yohandev/6115-final-project/proposal/images/hardware_overview.png

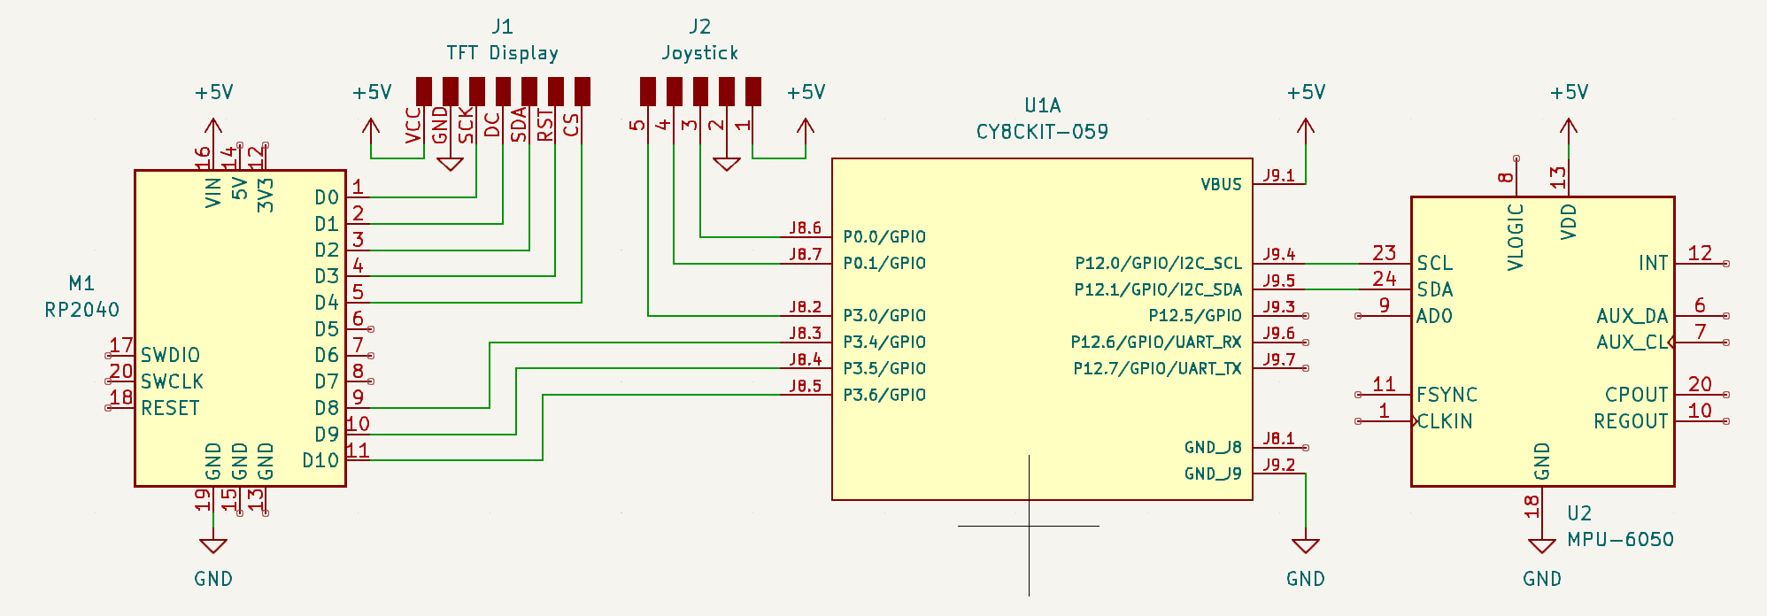
proposal/images/hardware_overview.png
