yohandev/6115-final-project/proposal/images/pcb.png

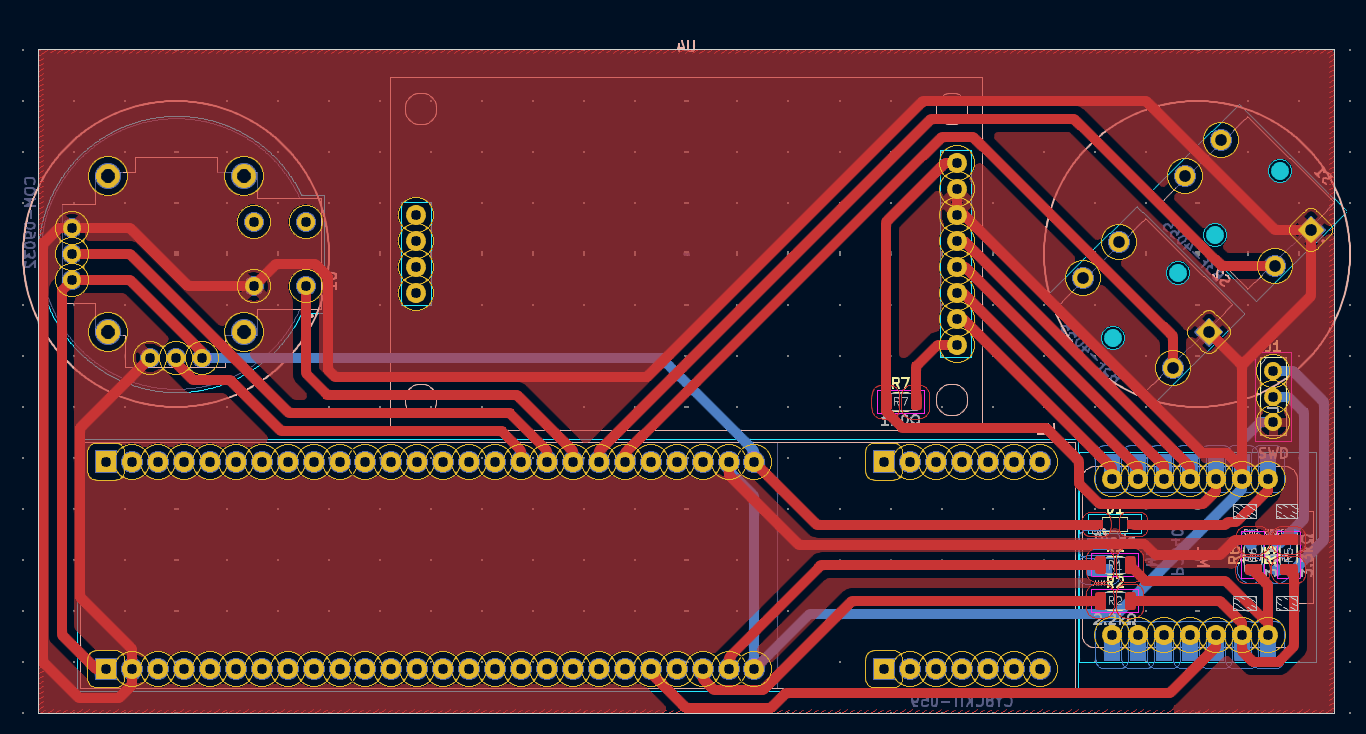
proposal/images/pcb.png
