yohandev/6115-final-project/writeup/images/bench0.png

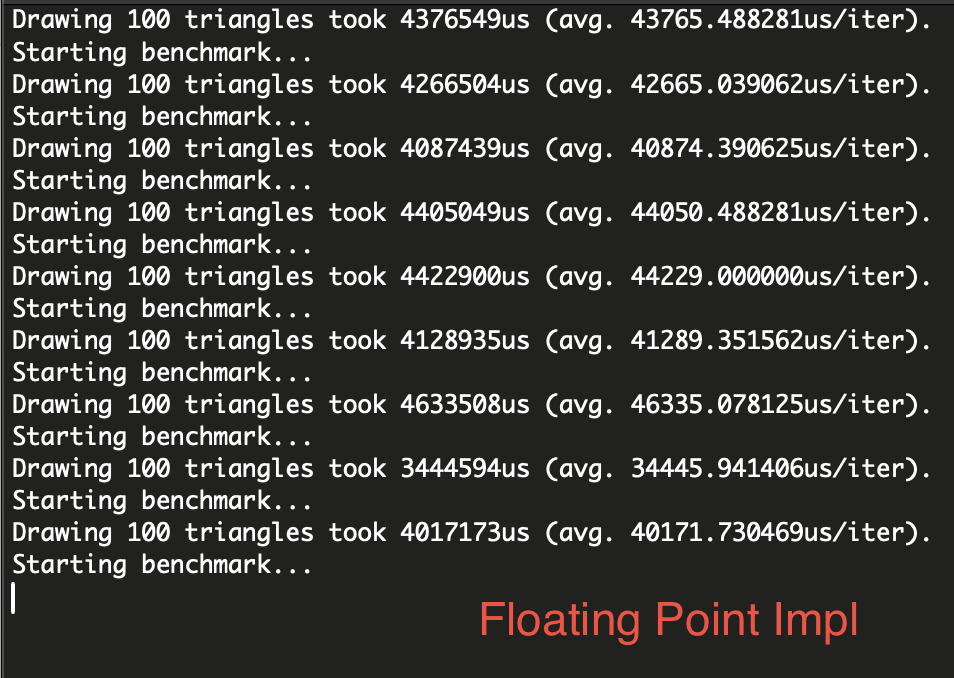
writeup/images/bench0.png
