yohandev/6115-final-project/writeup/images/bench1.png

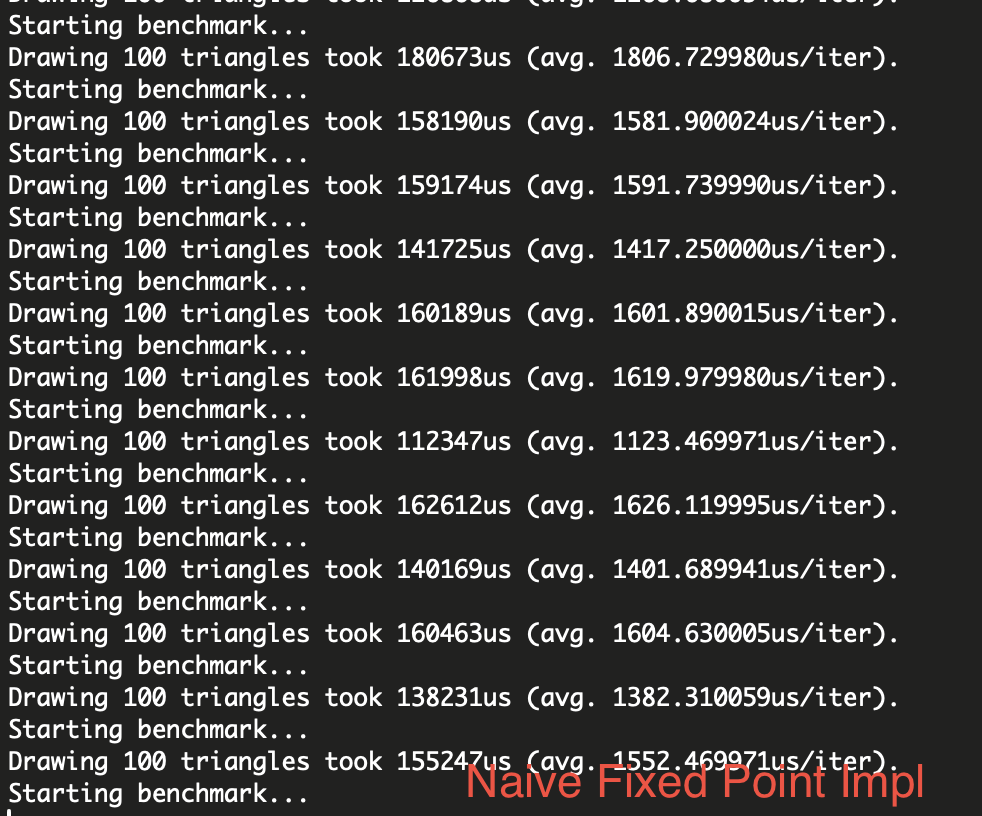
writeup/images/bench1.png
