yohandev/6115-final-project/writeup/images/bench2.png

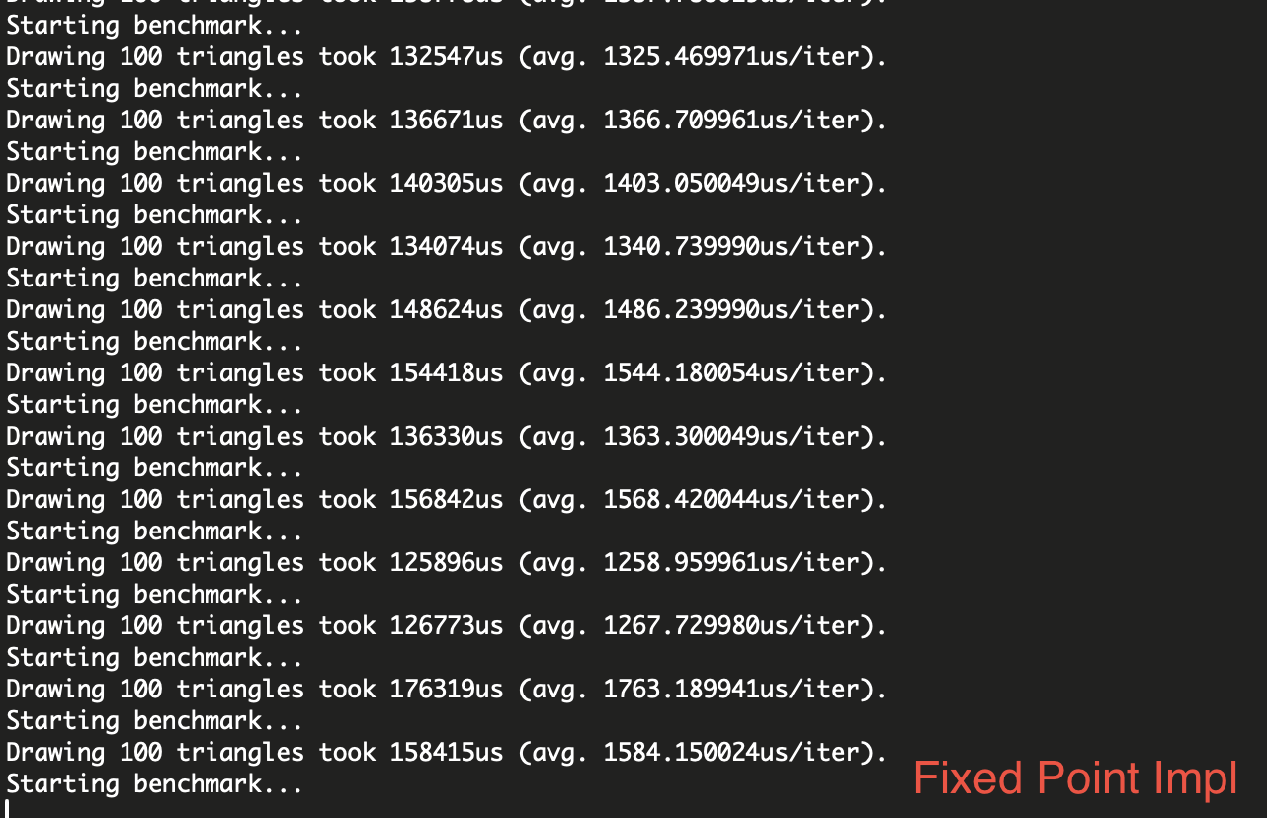
writeup/images/bench2.png
