yohandev/6115-final-project/writeup/images/bench3.png

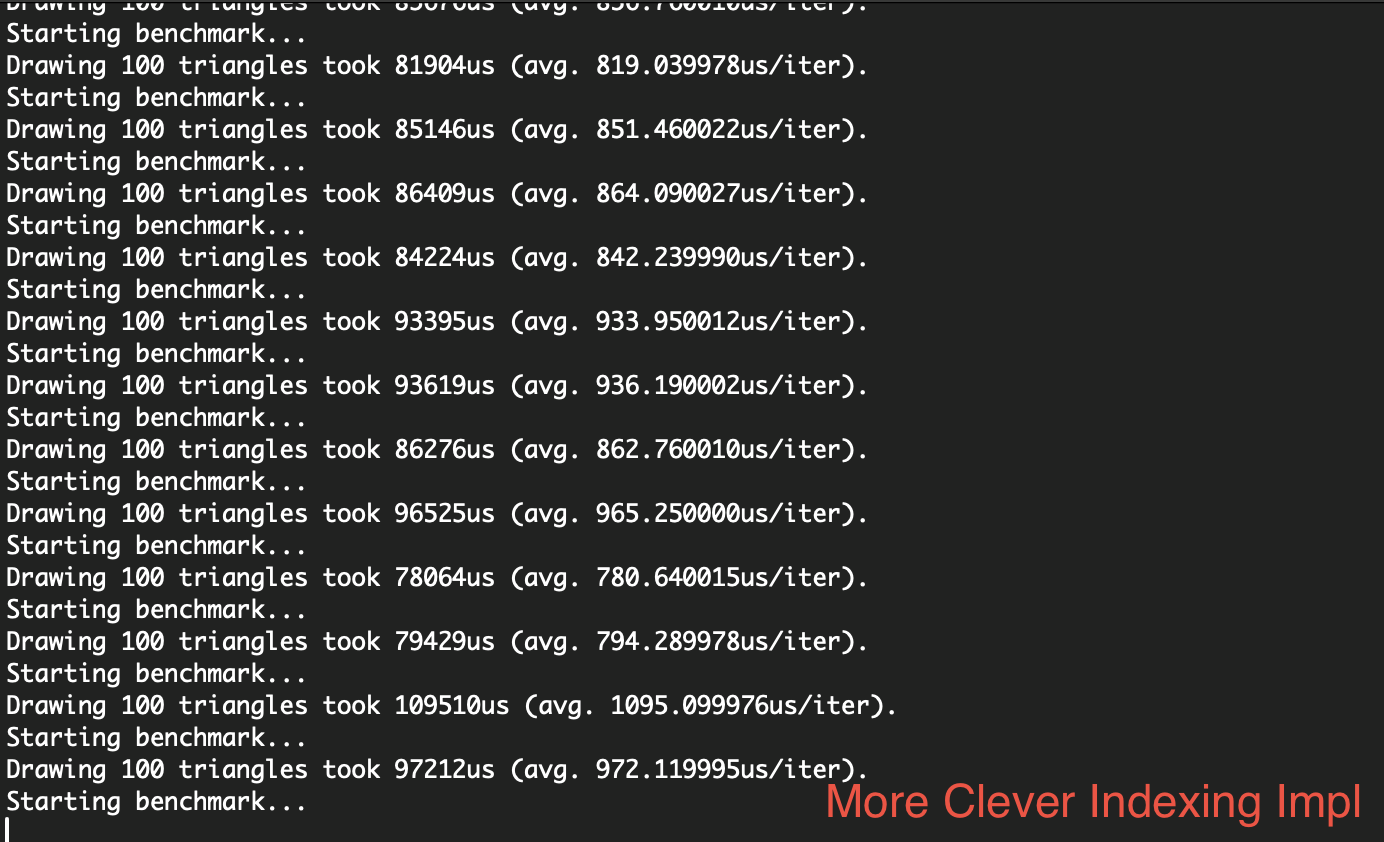
writeup/images/bench3.png
