yohandev/6115-final-project/writeup/images/casing.png

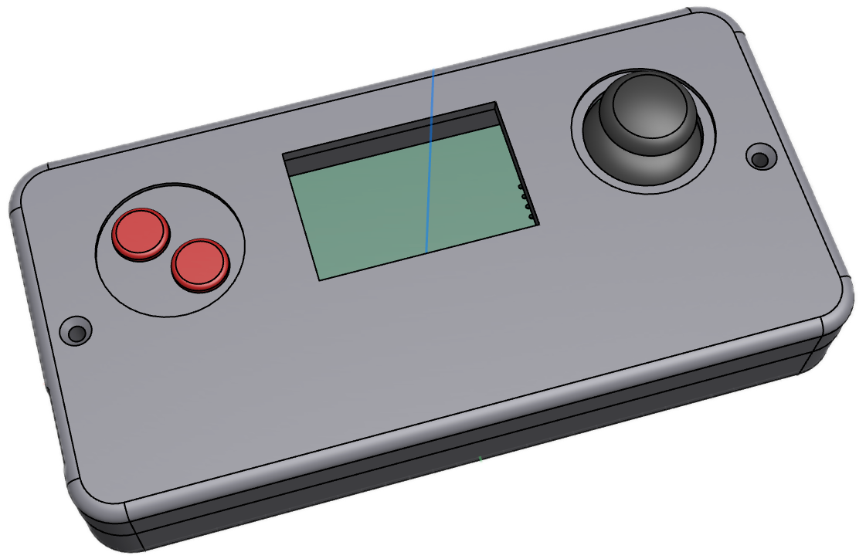
writeup/images/casing.png
