yohandev/6115-final-project/writeup/images/firmware.png

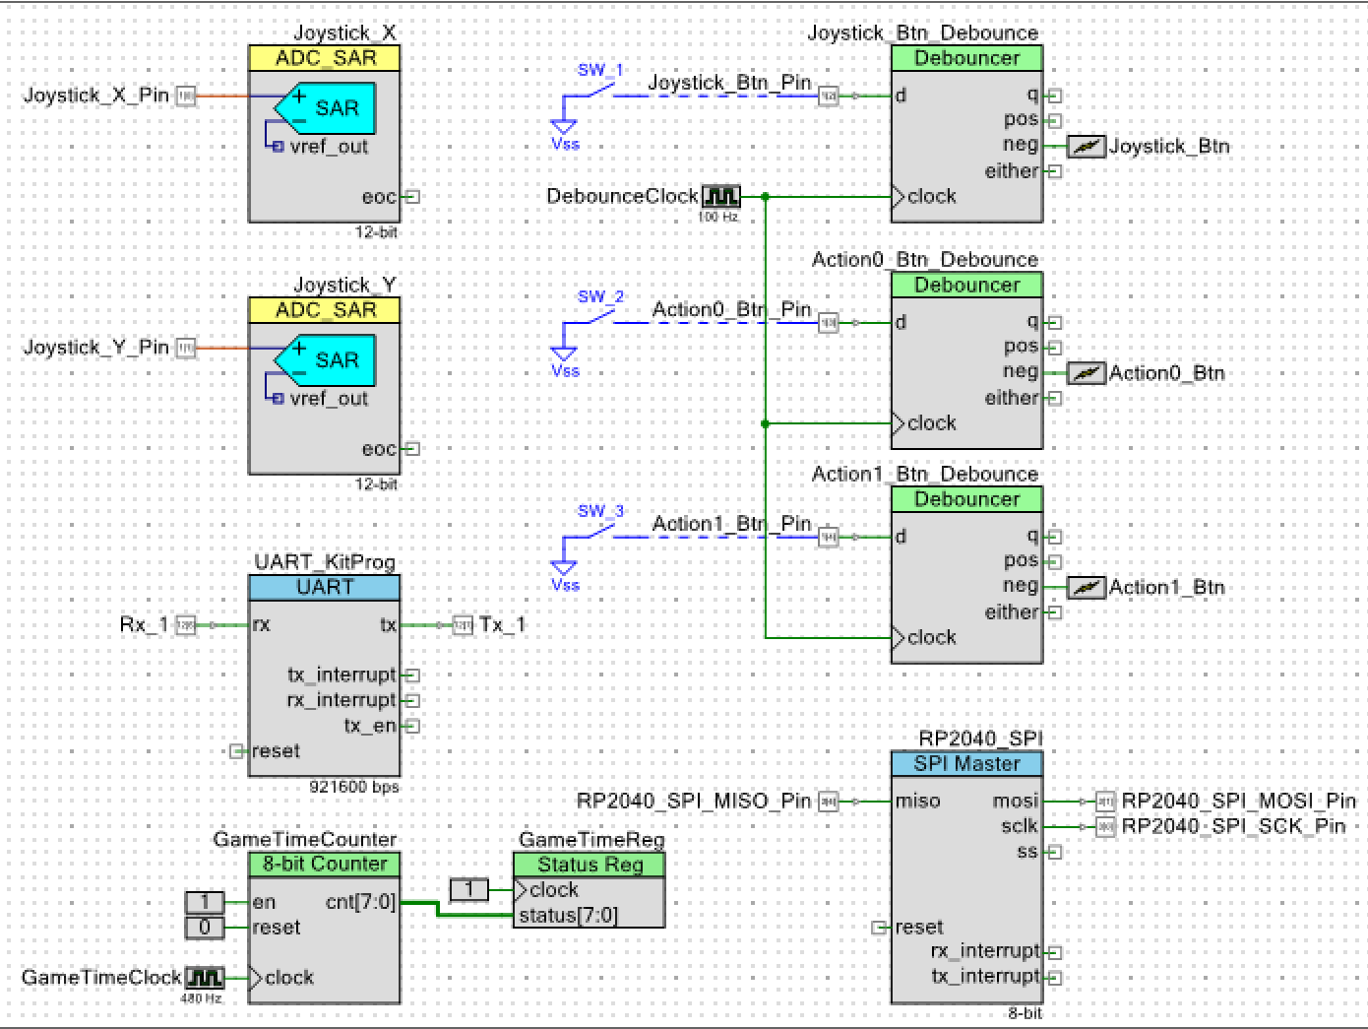
writeup/images/firmware.png
