yohandev/6115-final-project/writeup/images/pcb_3d.png

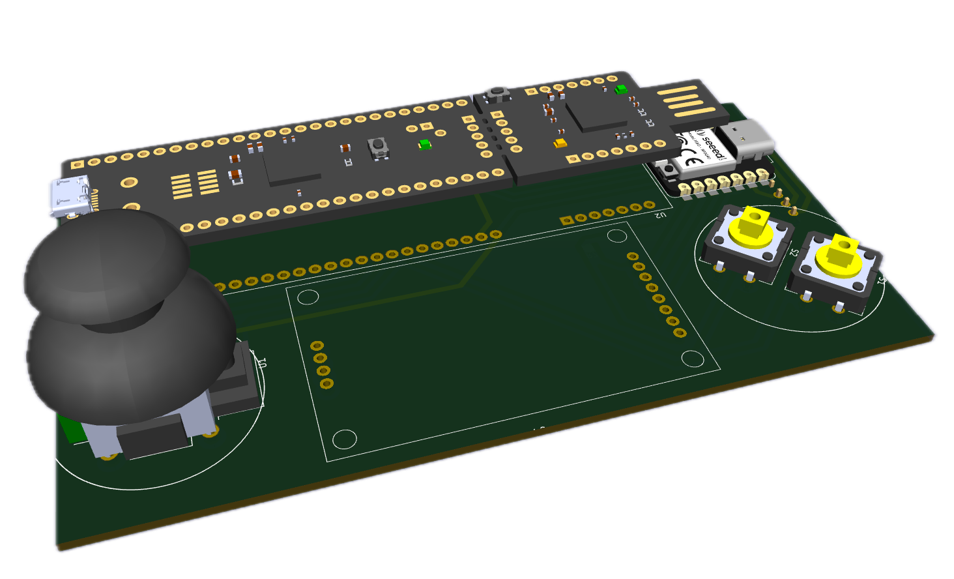
writeup/images/pcb_3d.png
