yohandev/6115-final-project/writeup/images/schematic.png

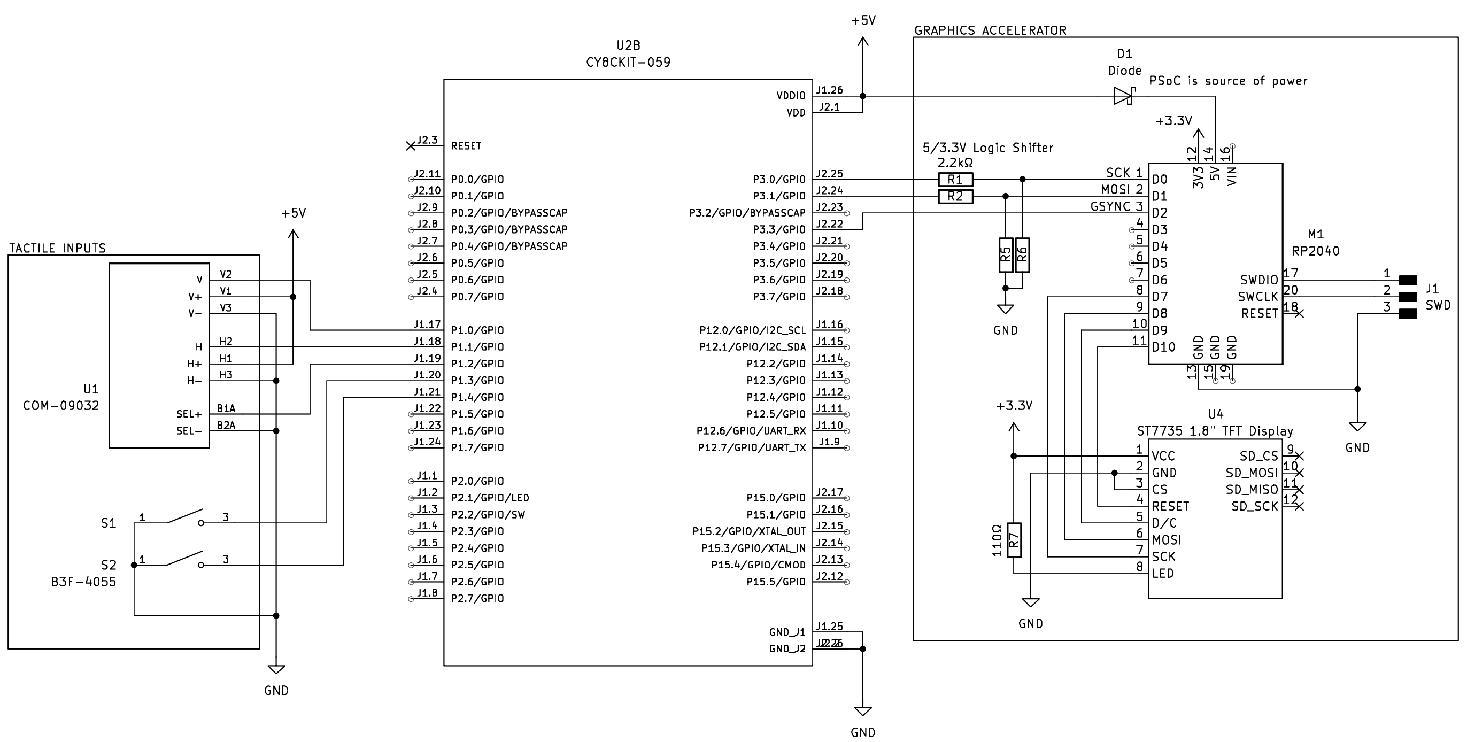
writeup/images/schematic.png
