yohandev/6115-final-project/writeup/images/star_destroyer.png

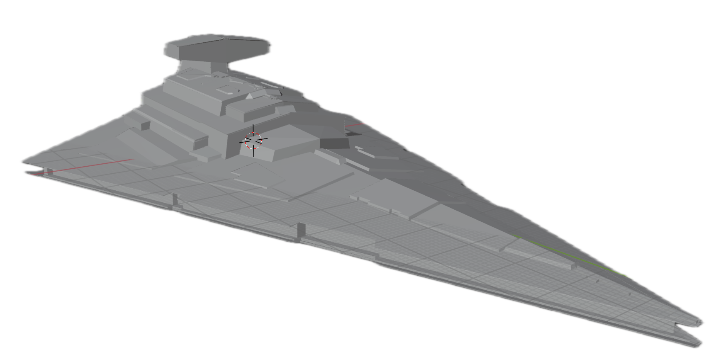
writeup/images/star_destroyer.png
