yohandev/6115-final-project/writeup/images/x_wing.png

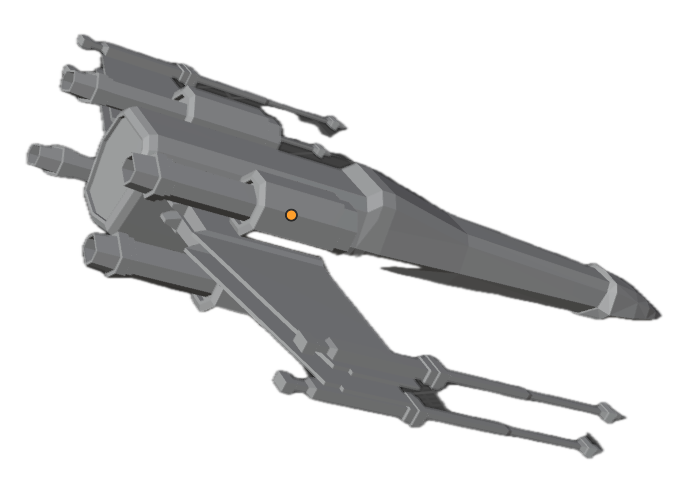
writeup/images/x_wing.png
