yohandev/6115-final-project/assets/asteroid.ply

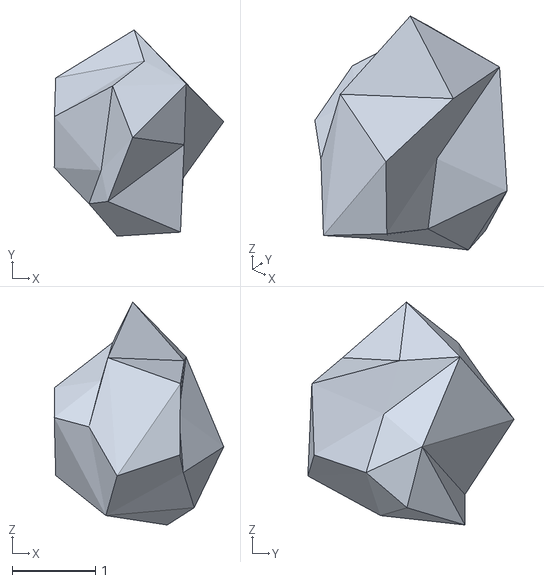
[picture p16: CAD file, 2024-05-02]
assets/asteroid.ply
2.04 x 2.48 x 2.68
