yohandev/6115-final-project/pcb/switch_cap.3mf

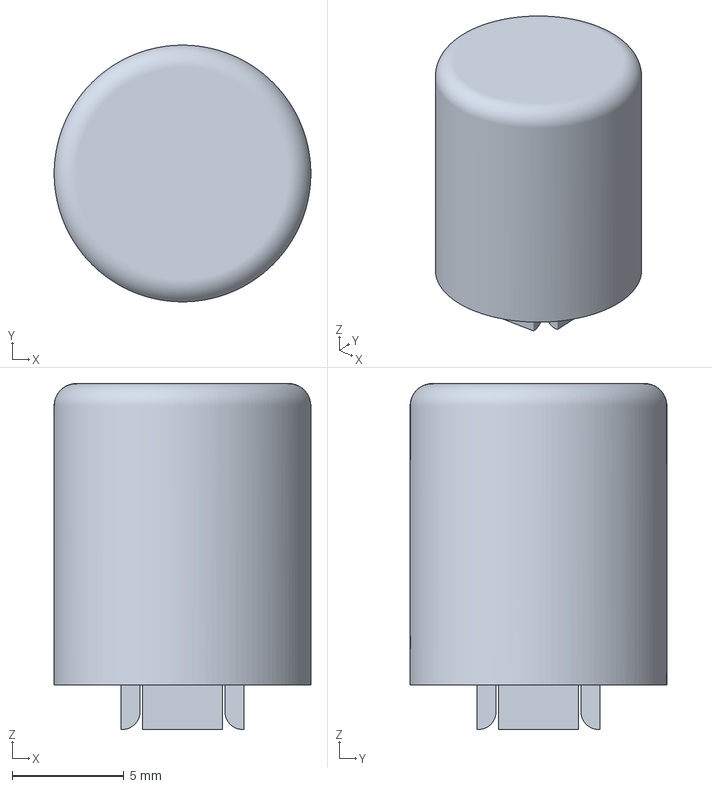
[picture p17: CAD file, 2024-04-25]
pcb/switch_cap.3mf
11.5 x 11.5 x 15.5 mm
