yohandev/6115-final-project/assets/debug_camera.ply

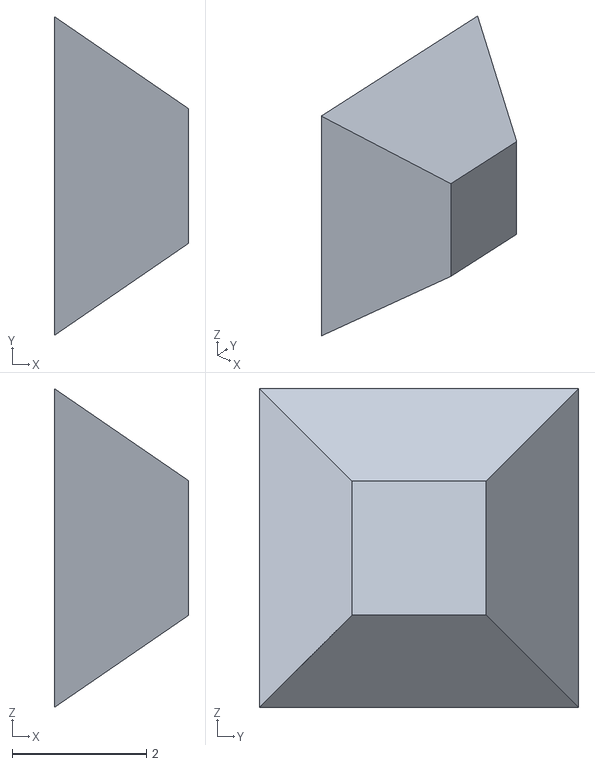
[picture p18: CAD file, 2024-05-02]
assets/debug_camera.ply
2.00 x 4.74 x 4.74
