yohandev/6115-final-project/pcb/case_top.3mf

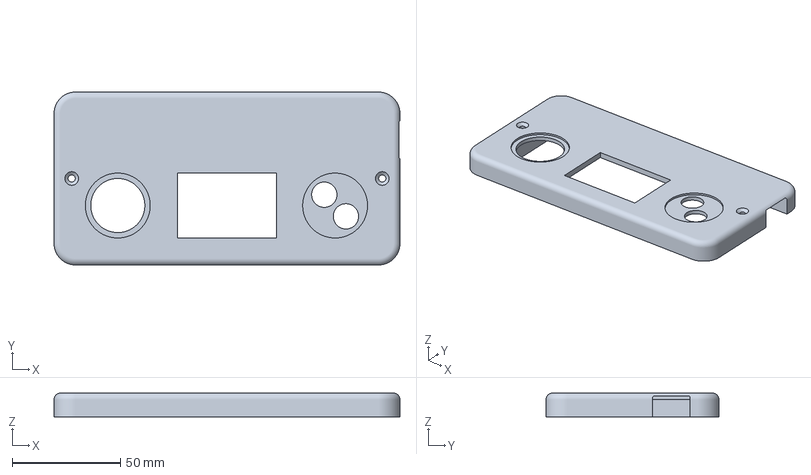
[picture p19: CAD file, 2024-04-25]
pcb/case_top.3mf
160.0 x 80.0 x 11.0 mm
