yohandev/6115-final-project/assets/x_wing.ply

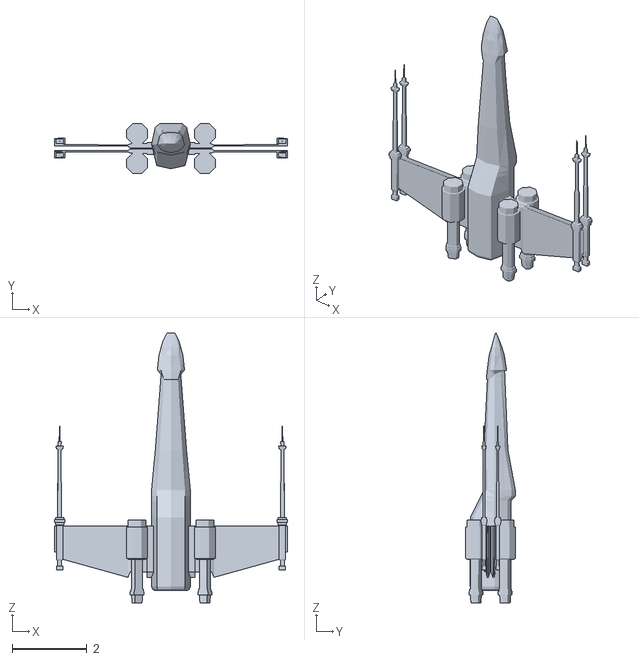
[picture p20: CAD file, 2024-05-02]
assets/x_wing.ply
6.26 x 1.35 x 7.24
