yohandev/6115-final-project/pcb/case_bottom.3mf

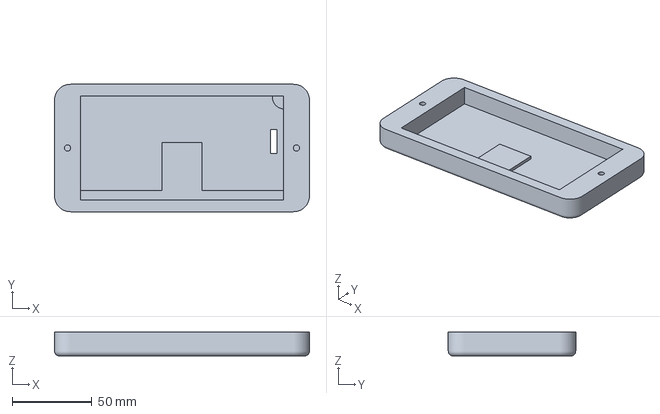
[picture p21: CAD file, 2024-04-25]
pcb/case_bottom.3mf
160.0 x 80.0 x 15.0 mm
