yohandev/6115-final-project/assets/star_destroyer.ply

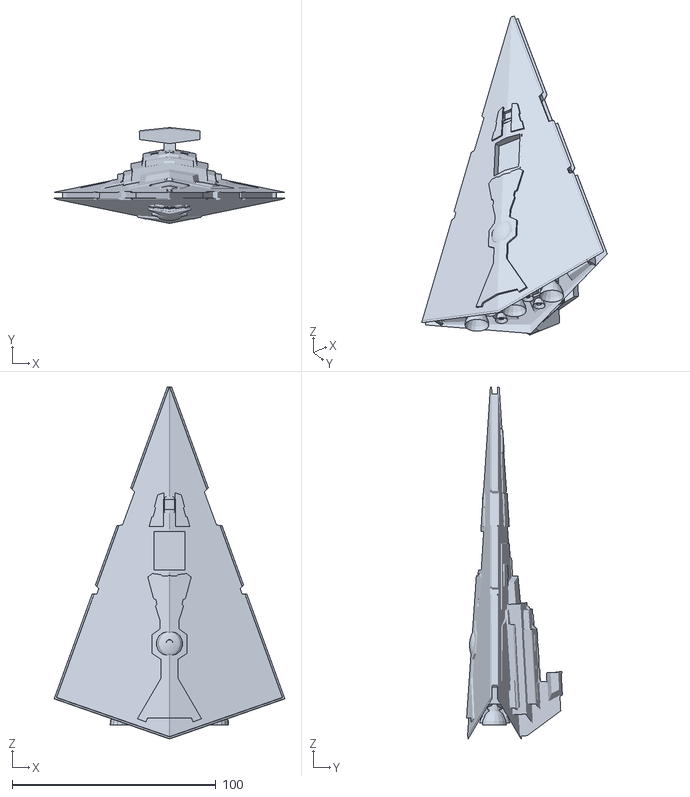
[picture p22: CAD file, 2024-05-02]
assets/star_destroyer.ply
113.3 x 47.1 x 172.8
