yohandev/6115-final-project/(list of files, cad)

Other CAD files:
assets/scene.blend
