yohandev/6115-final-project/pcb/pcb.kicad_pcb

## KiCad design pcb/pcb.kicad_pcb (2024-04-23)

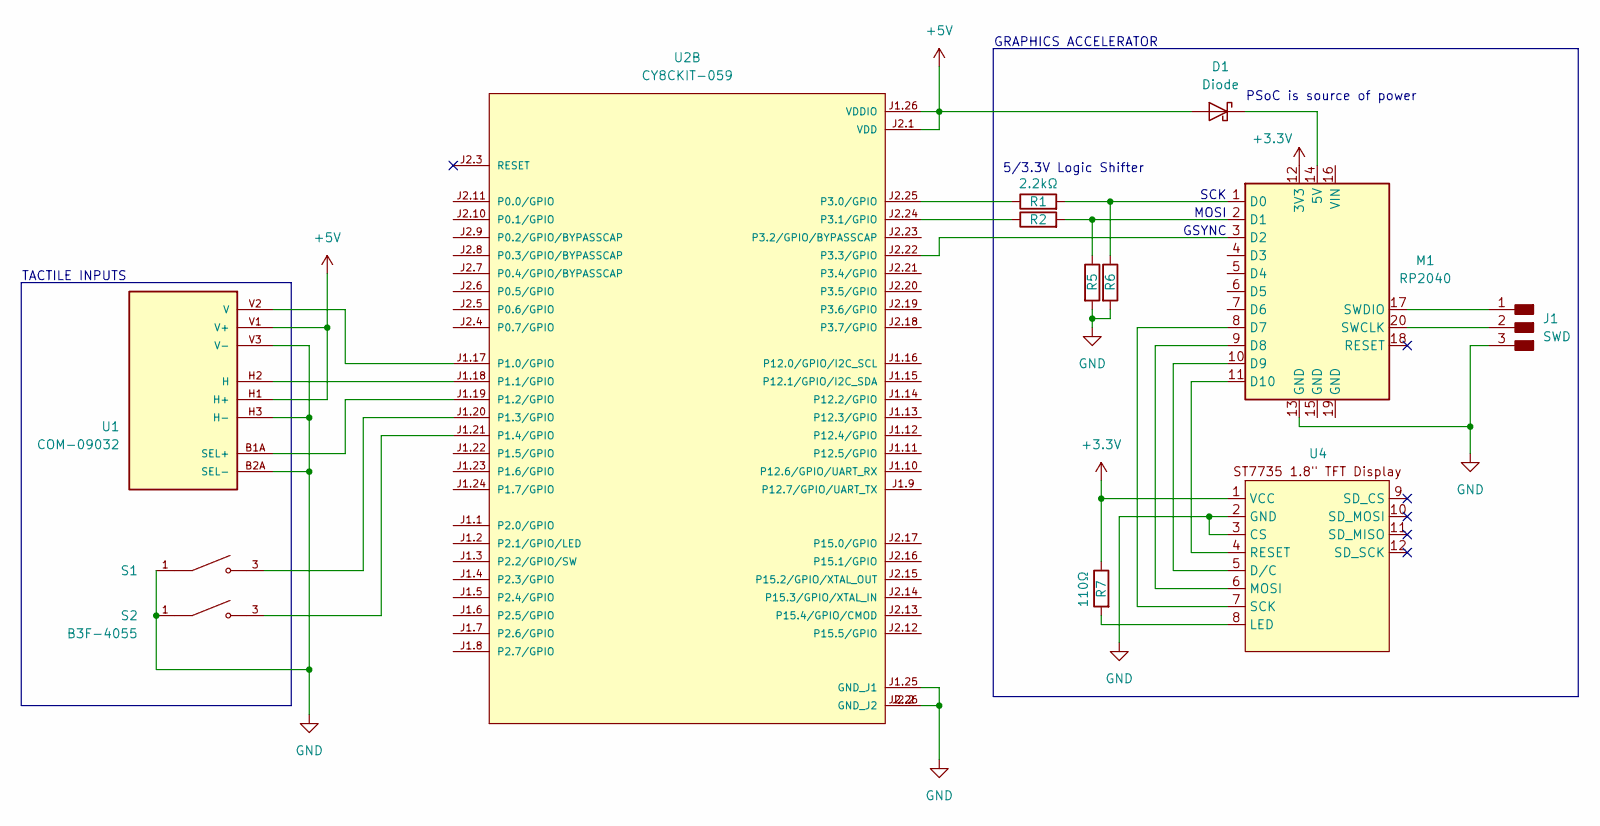
[picture p23: schematic pcb.kicad_sch]

Parts:
D1: Diode; SOD-123
J1: SWD; PinHeader_1x03_P2.54mm_Vertical_THT_D1mm
M1: RP2040; SeeedStudio_XIAO_RP2040
R1, R2: 2.2kΩ; R_1206_3216Metric
R5, R6: 3.3kΩ; R_1206_3216Metric
R7: 110Ω; R_1206_3216Metric
S1, S2: B3F-4055; SW_B3F-4055; PARTREV A070-E1-08
U1: COM-09032; XDCR_COM-09032; PARTREV N/A
U2: CY8CKIT-059; MODULE_CY8CKIT-059; PARTREV G
U4: ST7735

Connections:
+3.3V: M1.12 (3V3), R7.1, U4.1 (VCC)
+5V: D1.2 (A), U1.H1 (H+), U1.V1 (V+), U2.J1.26 (VDDIO), U2.J2.1 (VDD)
GND: J1.3, M1.13 (GND), R5.2, R6.2, S1.1, S2.1, U1.B2A (SEL-), U1.H3 (H-), U1.V3 (V-), U2.J1.25 (GND_J1), U2.J2.2 (GND_J2), U2.J2.26 (GND_J2), U4.2 (GND), U4.3 (CS)
unnamed: D1.1 (K), M1.14 (5V)
unnamed: J1.1, M1.17 (SWDIO)
unnamed: J1.2, M1.20 (SWCLK)
unnamed: M1.1 (D0), R1.2, R6.1
unnamed: M1.2 (D1), R2.2, R5.1
unnamed: M1.3 (D2), U2.J2.22 (P3.3/GPIO)
unnamed: M1.8 (D7), U4.7 (SCK)
unnamed: M1.9 (D8), U4.6 (MOSI)
unnamed: M1.10 (D9), U4.5 (D/C)
unnamed: M1.11 (D10), U4.4 (RESET)
unnamed: U1.H2 (H), U2.J1.18 (P1.1/GPIO)
unnamed: U1.B1A (SEL+), U2.J1.19 (P1.2/GPIO)
unnamed: U1.V2 (V), U2.J1.17 (P1.0/GPIO)
unnamed: S1.3, U2.J1.20 (P1.3/GPIO)
unnamed: S2.3, U2.J1.21 (P1.4/GPIO)
unnamed: R1.1, U2.J2.25 (P3.0/GPIO)
unnamed: R2.1, U2.J2.24 (P3.1/GPIO)
unnamed: R7.2, U4.8 (LED)

Notes on the sheet:
GRAPHICS ACCELERATOR
MOSI
5/3.3V Logic Shifter
GSYNC
SCK
TACTILE INPUTS
PSoC is source of power

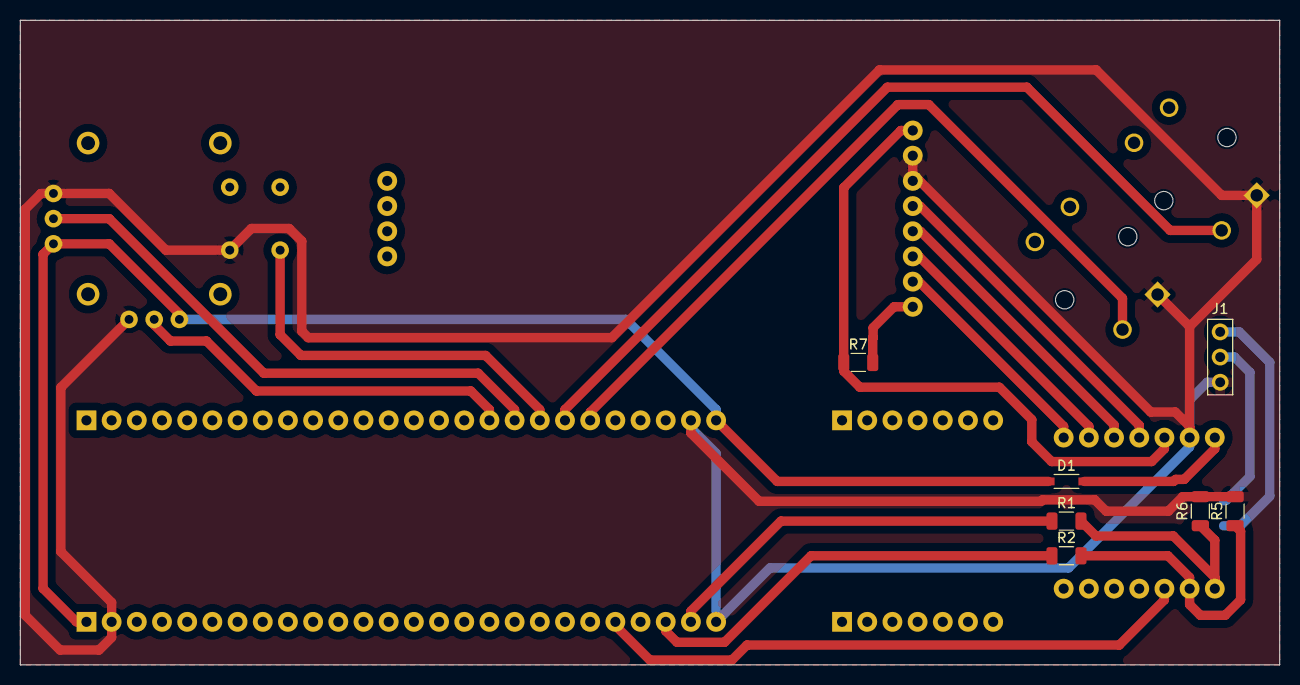
[picture p24: board pcb.kicad_pcb from above]

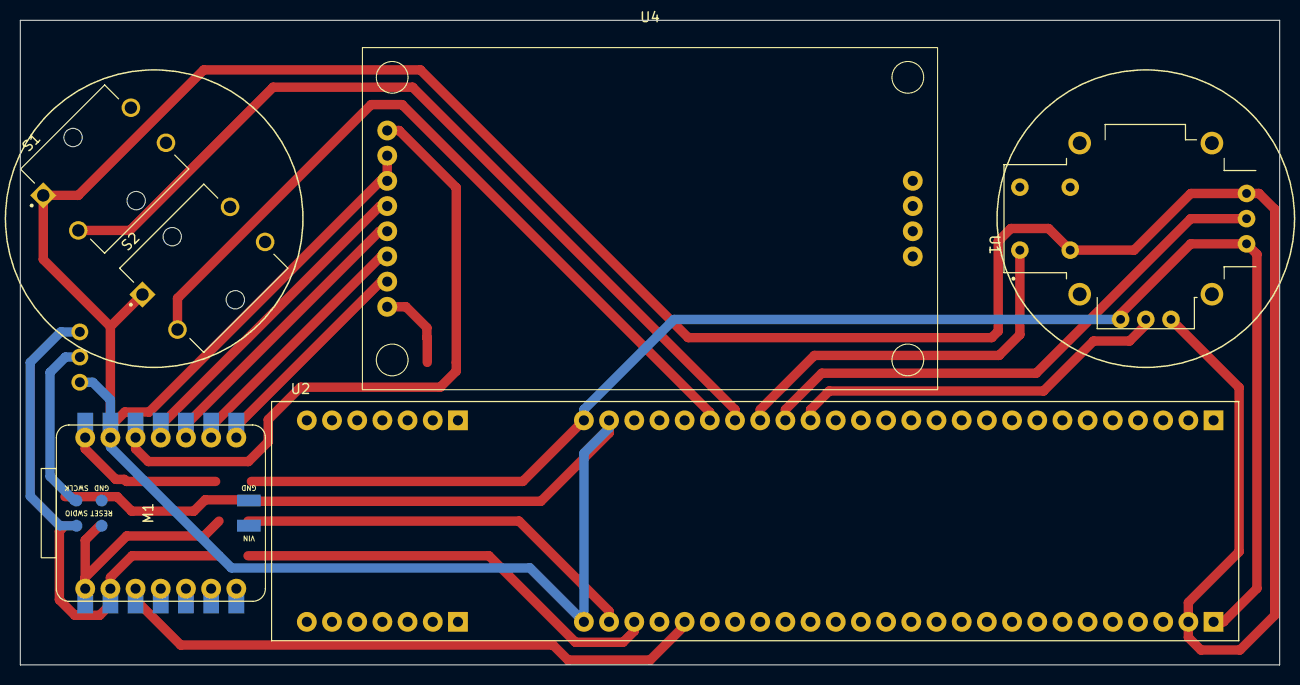
[picture p25: board pcb.kicad_pcb from below]

Board: 2 copper layers, 127.0 x 65.0 mm, 13 parts (6 on the bottom side), 21 nets.
