yohandev/6115-final-project/rp2040/src/main.c

#include <stdio.h>
#include <math.h>

#include "pico/stdlib.h"
// #include "pico/stdio_rtt.h"
#include "hardware/pio.h"
#include "hardware/gpio.h"
#include "hardware/interp.h"

#include "raspberry_256x256_rgb565.h"
#include "monke.h"

#include "framebuffer.h"
#include "rasterizer.h"
#include "st7789.h"
#include "psoc_rx.h"

struct LCD display = {
    .pins = {
        .clk = 1,
        .mosi = 2,
        .dc = 4,
        .rst = 3,
    },
    .pio = pio0,
    .sm = 0,
    .dma = -1,
};

struct PsocRx psoc = {
    .pins = {
        .mosi = 26,
        .sck = 27,
    },
    .pio = pio0,
    .sm = 1,
};

// Tested with the parts that have the height of 240 and 320
#define SCREEN_WIDTH 128
#define SCREEN_HEIGHT 160
#define IMAGE_SIZE 256
#define LOG_IMAGE_SIZE 8

#ifndef M_PI
#define M_PI 3.14159265358979323846
#endif

int main() {
    set_sys_clock_khz(250000, true);
    stdio_init_all();

    lcd_init(&display);
    psoc_rx_init(&psoc);

    // Other SDKs: static image on screen, lame, boring
    // Raspberry Pi Pico SDK: spinning image on screen, bold, exciting

    // Lane 0 will be u coords (bits 8:1 of addr offset), lane 1 will be v
    // coords (bits 16:9 of addr offset), and we'll represent coords with
    // 16.16 fixed point. ACCUM0,1 will contain current coord, BASE0/1 will
    // contain increment vector, and BASE2 will contain image base pointer
#define UNIT_LSB 16
    interp_config lane0_cfg = interp_default_config();
    interp_config_set_shift(&lane0_cfg, UNIT_LSB - 1); // -1 because 2 bytes per pixel
    interp_config_set_mask(&lane0_cfg, 1, 1 + (LOG_IMAGE_SIZE - 1));
    interp_config_set_add_raw(&lane0_cfg, true); // Add full accumulator to base with each POP
    interp_config lane1_cfg = interp_default_config();
    interp_config_set_shift(&lane1_cfg, UNIT_LSB - (1 + LOG_IMAGE_SIZE));
    interp_config_set_mask(&lane1_cfg, 1 + LOG_IMAGE_SIZE, 1 + (2 * LOG_IMAGE_SIZE - 1));
    interp_config_set_add_raw(&lane1_cfg, true);

    interp_set_config(interp0, 0, &lane0_cfg);
    interp_set_config(interp0, 1, &lane1_cfg);
    interp0->base[2] = (u32) raspberry_256x256;

    f32 theta = 0.f;
    f32 theta_max = 2.f * (f32) M_PI;
    while (1) {
        u64 start = time_us_64();

        theta += 0.02f;
        if (theta > theta_max)
            theta -= theta_max;
        i32 rotate[4] = {
                (i32) (cosf(theta) * (1 << UNIT_LSB)), (i32) (-sinf(theta) * (1 << UNIT_LSB)),
                (i32) (sinf(theta) * (1 << UNIT_LSB)), (i32) (cosf(theta) * (1 << UNIT_LSB))
        };
        interp0->base[0] = rotate[0];
        interp0->base[1] = rotate[2];

        struct Framebuffer* sbuf = framebuffer_get_current();

        usize i = 0;
        for (int y = 0; y < SCREEN_HEIGHT; ++y) {
            interp0->accum[0] = rotate[1] * y;
            interp0->accum[1] = rotate[3] * y;
            for (int x = 0; x < SCREEN_WIDTH; ++x) {
                uint16_t colour = *(uint16_t *) (interp0->pop[2]);

                framebuffer_get(sbuf, x, y) = (rgb){((colour >> 8) | (colour << 8))};
            }
        }
        // rasterizer_draw_triangle(
        //     sbuf,
        //     (vec2f){ .x=20, .y=20 },
        //     (vec2f){ .x=130, .y=30 },
        //     (vec2f){ .x=200, .y=200 }
        // );
        // rasterizer_triangle_bench(sbuf, 100, 9);

        mat4f translation = mat4f_translation((vec3f) {
            .x=cosf(theta * 2) * 10.0,
            .y=sinf(theta * 3) * 10.0,
            .z=15.0 + sinf(theta) * 5.0,
        });
        mat4f rotation = mat4f_rotation_y(theta);
        mat4f mvp = mat4f_mul(&translation, &rotation);
        mat4s mvps = mat4f_to_mat4s(&mvp);

        rasterizer_draw_mesh(sbuf, &HMMM_MONKE, &mvps);

        framebuffer_swap();
        lcd_put(&display, (u8*)framebuffer_get_offscreen()->pixels);

        u64 end = time_us_64();

        printf("Frame took %lldms\n", (end - start) / 1000);
    }
}
