yohandev/6115-final-project/rp2040/src/monke.h

// Origin mesh: /Users/yohan/Downloads/monke.ply
// Converted using scripts/meshgen.py
#include "num.h"
#include "mesh.h"

static const fixed16 VERTICES[] = {
    560, 210, 980,
    -560, 210, 980,
    640, 120, 880,
    -640, 120, 880,
    700, 70, 740,
    -700, 70, 740,
    450, -30, 790,
    -450, -30, 790,
    450, 40, 920,
    -450, 40, 920,
    450, 170, 1000,
    -450, 170, 1000,
    350, 210, 1020,
    -350, 210, 1020,
    260, 120, 950,
    -260, 120, 950,
    200, 70, 830,
    -200, 70, 830,
    100, 310, 840,
    -100, 310, 840,
    180, 310, 950,
    -180, 310, 950,
    310, 310, 1020,
    -310, 310, 1020,
    350, 420, 1020,
    -350, 420, 1020,
    260, 500, 950,
    -260, 500, 950,
    200, 560, 830,
    -200, 560, 830,
    450, 660, 790,
    -450, 660, 790,
    450, 580, 920,
    -450, 580, 920,
    450, 460, 1000,
    -450, 460, 1000,
    560, 420, 980,
    -560, 420, 980,
    640, 500, 880,
    -640, 500, 880,
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
};

static const u16 INDICES[] = {
    46, 2, 44,
    3, 47, 45,
    44, 4, 42,
    5, 45, 43,
    2, 6, 4,
    7, 3, 5,
    0, 8, 2,
    9, 1, 3,
    10, 14, 8,
    15, 11, 9,
    8, 16, 6,
    17, 9, 7,
    20, 16, 14,
    21, 17, 19,
    12, 20, 14,
    21, 13, 15,
    22, 26, 20,
    27, 23, 21,
    26, 18, 20,
    27, 19, 29,
    32, 28, 26,
    33, 29, 31,
    34, 26, 24,
    35, 27, 33,
    36, 32, 34,
    37, 33, 39,
    38, 30, 32,
    39, 31, 41,
    44, 40, 38,
    45, 41, 43,
    46, 38, 36,
    47, 39, 45,
    36, 48, 46,
    37, 49, 51,
    34, 50, 36,
    35, 51, 53,
    24, 52, 34,
    25, 53, 55,
    22, 54, 24,
    23, 55, 57,
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
};

static const struct ColorRange COLORS[] = {
    { 0, 0 },
};

const struct Mesh HMMM_MONKE = {
    .vertices = VERTICES,
    .indices = INDICES,
    .colors = COLORS,

    .num_vertices = 507,
    .num_faces = 967,
    .num_colors = 1,
};
