yohandev/6115-final-project/psoc/GameLogic.cydsn/gpu.c

#include <project.h>

#include "gpu.h"

// #define EMULATED_GPU

#ifdef EMULATED_GPU
/**
 * Implementation running graphics processing on a host laptop via serial
*/

enum PayloadType {
    PACKET_OVER = 0x80,     // Start at an invalid ASCII character so printing can happen too
    UPLOAD_MESH,
    CLEAR_BUFFER,
    SWAP_BUFFER,
    SET_CAMERA,
    DRAW_INSTANCED,
    DRAW_INSTANCED_QUAT,
    DRAW_INSTANCED_SCALE,
};

void UART_KitProg_PutMany(const u8* data, usize len) {
    while (len > 0) {
        u8 tx = len > 255 ? 255 : len;
        
        UART_KitProg_PutArray(data, tx);
        
        data += tx;
        len -= tx;
    }
}

void gpu_init() {
    UART_KitProg_Start();
    
    CyDelay(500);

    // Wait for serial to be ready
    UART_KitProg_ClearRxBuffer();
    while (!UART_KitProg_GetRxBufferSize()) {

    }
    UART_KitProg_ClearRxBuffer();
    CyDelay(200);
}

bool gpu_is_ready() {
    return true;
}

void gpu_upload_mesh(usize id, const struct Mesh* mesh) {
    // Header
    UART_KitProg_PutChar(UPLOAD_MESH);
    // Mesh identifier
    UART_KitProg_PutArray((u8*)&id, sizeof(usize));
    // Vertices
    UART_KitProg_PutArray((u8*)&mesh->num_vertices, sizeof(usize));
    UART_KitProg_PutMany((u8*)mesh->vertices, mesh->num_vertices * 3 * sizeof(u16));
    // Indices
    UART_KitProg_PutArray((u8*)&mesh->num_faces, sizeof(usize));
    UART_KitProg_PutMany((u8*)mesh->indices, mesh->num_faces * 3 * sizeof(u16));
    // Color
    UART_KitProg_PutArray((u8*)&mesh->num_colors, sizeof(usize));
    UART_KitProg_PutMany((u8*)mesh->colors, mesh->num_colors * sizeof(struct ColorRange));
    // Footer
    UART_KitProg_PutChar(PACKET_OVER);
}

void gpu_clear_buffer() {
    // Header
    UART_KitProg_PutChar(CLEAR_BUFFER);
    // Footer
    UART_KitProg_PutChar(PACKET_OVER);
}

void gpu_swap_buffer() {
    // Header
    UART_KitProg_PutChar(SWAP_BUFFER);
    // Footer
    UART_KitProg_PutChar(PACKET_OVER);
}

void gpu_set_camera(vec3f pos, quat rot) {
    // Header
    UART_KitProg_PutChar(SET_CAMERA);
    // Payload
    UART_KitProg_PutArray((u8*)&pos, sizeof(vec3f));
    UART_KitProg_PutArray((u8*)&rot, sizeof(quat));
    // Footer
    UART_KitProg_PutChar(PACKET_OVER);
}

void gpu_draw_instanced(usize id, usize len, vec3f* pos, vec3f* rot) {
    // Header
    UART_KitProg_PutChar(DRAW_INSTANCED);
    // Mesh identifier
    UART_KitProg_PutArray((u8*)&id, sizeof(usize));
    // Amount of instances
    UART_KitProg_PutArray((u8*)&len, sizeof(usize));
    // Transformations
    UART_KitProg_PutMany((u8*)pos, len * sizeof(vec3f));
    UART_KitProg_PutMany((u8*)rot, len * sizeof(vec3f));
    // Footer
    UART_KitProg_PutChar(PACKET_OVER);
}

void gpu_draw_instanced_quat(usize id, usize len, vec3f* pos, quat* rot) {
    // Header
    UART_KitProg_PutChar(DRAW_INSTANCED_QUAT);
    // Mesh identifier
    UART_KitProg_PutArray((u8*)&id, sizeof(usize));
    // Amount of instances
    UART_KitProg_PutArray((u8*)&len, sizeof(usize));
    // Transformations
    UART_KitProg_PutMany((u8*)pos, len * sizeof(vec3f));
    UART_KitProg_PutMany((u8*)rot, len * sizeof(quat));
    // Footer
    UART_KitProg_PutChar(PACKET_OVER);
}

void gpu_draw_instanced_scale(usize id, usize len, vec3f* pos, vec3f* rot, f32* scale) {
    // Header
    UART_KitProg_PutChar(DRAW_INSTANCED_SCALE);
    // Mesh identifier
    UART_KitProg_PutArray((u8*)&id, sizeof(usize));
    // Amount of instances
    UART_KitProg_PutArray((u8*)&len, sizeof(usize));
    // Transformations
    UART_KitProg_PutMany((u8*)pos, len * sizeof(vec3f));
    UART_KitProg_PutMany((u8*)rot, len * sizeof(vec3f));
    UART_KitProg_PutMany((u8*)scale, len * sizeof(f32));
    // Footer
    UART_KitProg_PutChar(PACKET_OVER);
}

#else
// Implementation running on the RP2040
enum PayloadType {
    PACKET_OVER,
    UPLOAD_MESH,
    CLEAR_BUFFER,
    SWAP_BUFFER,
    SET_CAMERA,
    DRAW_INSTANCED,
    DRAW_INSTANCED_QUAT,
    DRAW_INSTANCED_SCALE,
};

void RP2040_SPI_PutMany(const u8* data, usize len) {
    while (len > 0) {
        u8 tx = len > 255 ? 255 : len;
        
        RP2040_SPI_PutArray(data, tx);
        
        data += tx;
        len -= tx;
    }
}

void RP2040_SPI_PutChar(const u8 data) {
    RP2040_SPI_PutArray(&data, 1);
}

void gpu_init() {
    RP2040_SPI_Start();
}

bool gpu_is_ready() {
    return true; // TODO: check v-sync line
}

void gpu_upload_mesh(usize id, const struct Mesh* mesh) {
    // Header
    RP2040_SPI_PutChar(UPLOAD_MESH);
    // Mesh identifier
    RP2040_SPI_PutArray((u8*)&id, sizeof(usize));
    // Vertices
    RP2040_SPI_PutArray((u8*)&mesh->num_vertices, sizeof(usize));
    RP2040_SPI_PutMany((u8*)mesh->vertices, mesh->num_vertices * 3 * sizeof(u16));
    // Indices
    RP2040_SPI_PutArray((u8*)&mesh->num_faces, sizeof(usize));
    RP2040_SPI_PutMany((u8*)mesh->indices, mesh->num_faces * 3 * sizeof(u16));
    // Color
    RP2040_SPI_PutArray((u8*)&mesh->num_colors, sizeof(usize));
    RP2040_SPI_PutMany((u8*)mesh->colors, mesh->num_colors * sizeof(struct ColorRange));
    // Footer
    RP2040_SPI_PutChar(PACKET_OVER);
}

void gpu_clear_buffer() {
    // Header
    RP2040_SPI_PutChar(CLEAR_BUFFER);
    // Footer
    RP2040_SPI_PutChar(PACKET_OVER);
}

void gpu_swap_buffer() {
    // Header
    RP2040_SPI_PutChar(SWAP_BUFFER);
    // Footer
    RP2040_SPI_PutChar(PACKET_OVER);
}

void gpu_set_camera(vec3f pos, quat rot) {
    // Header
    RP2040_SPI_PutChar(SET_CAMERA);
    // Payload
    RP2040_SPI_PutArray((u8*)&pos, sizeof(vec3f));
    RP2040_SPI_PutArray((u8*)&rot, sizeof(quat));
    // Footer
    RP2040_SPI_PutChar(PACKET_OVER);
}

void gpu_draw_instanced(usize id, usize len, vec3f* pos, vec3f* rot) {
    // Header
    RP2040_SPI_PutChar(DRAW_INSTANCED);
    // Mesh identifier
    RP2040_SPI_PutArray((u8*)&id, sizeof(usize));
    // Amount of instances
    RP2040_SPI_PutArray((u8*)&len, sizeof(usize));
    // Transformations
    RP2040_SPI_PutMany((u8*)pos, len * sizeof(vec3f));
    RP2040_SPI_PutMany((u8*)rot, len * sizeof(vec3f));
    // Footer
    RP2040_SPI_PutChar(PACKET_OVER);
}

void gpu_draw_instanced_quat(usize id, usize len, vec3f* pos, quat* rot) {
    // Header
    RP2040_SPI_PutChar(DRAW_INSTANCED_QUAT);
    // Mesh identifier
    RP2040_SPI_PutArray((u8*)&id, sizeof(usize));
    // Amount of instances
    RP2040_SPI_PutArray((u8*)&len, sizeof(usize));
    // Transformations
    RP2040_SPI_PutMany((u8*)pos, len * sizeof(vec3f));
    RP2040_SPI_PutMany((u8*)rot, len * sizeof(quat));
    // Footer
    RP2040_SPI_PutChar(PACKET_OVER);
}

void gpu_draw_instanced_scale(usize id, usize len, vec3f* pos, vec3f* rot, f32* scale) {
    // Header
    RP2040_SPI_PutChar(DRAW_INSTANCED_SCALE);
    // Mesh identifier
    RP2040_SPI_PutArray((u8*)&id, sizeof(usize));
    // Amount of instances
    RP2040_SPI_PutArray((u8*)&len, sizeof(usize));
    // Transformations
    RP2040_SPI_PutMany((u8*)pos, len * sizeof(vec3f));
    RP2040_SPI_PutMany((u8*)rot, len * sizeof(vec3f));
    RP2040_SPI_PutMany((u8*)scale, len * sizeof(f32));
    // Footer
    RP2040_SPI_PutChar(PACKET_OVER);
}
#endif
