yohandev/6115-final-project/psoc/GameLogic.cydsn/common/mesh.h

#ifndef MESH_H
#define MESH_H

#include "num.h"

// Meshes overview:
// Vertices (max of 65536) are stored in 8.8 fixed point (half of normal)
// Indices are therefore 16-bit integers
// No textures, but ranges of triangles (its indices) can take on a different color
//
// Consideration must be made to maximize this representation, e.g. the biggest mesh
// in the game should ideally have vertices almost maxing out the 8.8 fixed point. Also,
// because there is no per-vertex color, meshes with lots of similar color are preferred.
struct Mesh {
    const fixed16* vertices;
    const u16* indices;
    const struct ColorRange {
        u16 start;          // Starting face index where this color takes effect
        rgb rgb;
    }* colors;

    usize num_vertices;
    usize num_faces;
    usize num_colors;
};

#endif
