yohandev/6115-final-project/psoc/GameLogic.cydsn/world.c

#include "world.h"
#include "gpu.h"

struct World World = {};

void world_init() {
    // Asteroids
    for (usize i = 0; i < WORLD_ASTEROIDS_POOL_LEN; i++) {
        World.asteroids.pos[i] = vec3f_rand(2000.0);
        World.asteroids.rot[i] = vec3f_rand(PI);
        World.asteroids.scale[i] = 22.0 + 18.0 * randf();
    }

    // Star Destroyer
    World.star_destroyer.pos = (vec3f){ .x=20, .y=10, .z=20 };
}

void world_step() {
    // TODO: move the asteroids somehow
}
