yohandev/6115-final-project/rp2040/src/framebuffer.c

#include "framebuffer.h"

struct Framebuffer SBUF0 = {};
struct Framebuffer SBUF1 = {};

static struct Framebuffer* CURRENT = &SBUF0;
static struct Framebuffer* OFFSCREEN = &SBUF1;

struct Framebuffer* framebuffer_get_current() {
    return CURRENT;
}

struct Framebuffer* framebuffer_get_offscreen() {
    return OFFSCREEN;
}

void framebuffer_swap() {
    struct Framebuffer* tmp = CURRENT;
    
    CURRENT = OFFSCREEN;
    OFFSCREEN = tmp;
}
