yohandev/6115-final-project/rp2040/src/st7789.h

#pragma once

#include "hardware/pio.h"
#include "num.h"

struct LCD {
    struct {
        usize dc;
        usize rst;
        usize mosi;
        usize clk;    
    } pins;

    PIO pio;
    usize sm;
    i32 dma;
};

void lcd_init(struct LCD* self);
void lcd_put(struct LCD* self, const u8* buf);
