yohandev/6115-final-project/(commit log)

2024-04-23 Add initial proposal schematic
    [pcb.kicad_pcb, pcb.kicad_sch]
2024-04-23 Add project PCB
    [pcb.kicad_pcb, pcb.kicad_sch]
2024-04-25 Added single ADC to joystick for testing
2024-04-25 Added UART over ProgKit
2024-04-25 Added potentiometer + UART test
2024-04-25 Added joystick + buttons hardware and firmware
2024-04-25 Add PCB STEP file
2024-04-25 Add PCB casing files
    [case_bottom.3mf, case_top.3mf, switch_cap.3mf]
2024-04-26 Fix compiler errors and change to
    [asteroids.c, num.h]
2024-04-26 Add a throttle for now
2024-04-27 Add mesh file generation
    [star_destroyer.ply]
2024-04-29 Small fixes for UART communications
    [gpu.c, gpu.py]
2024-04-29 Fix mesh upload errors, PSoC side
    [gpu.c, main.c]
2024-04-29 Fix mesh upload errors, host side
    [gpu.py]
2024-04-30 Add X-Wing asset, rescale Star Destroyer asset
    [scene.blend, star_destroyer.ply, x_wing.ply]
2024-04-30 Add X-wing asset
2024-05-01 Switch to `trimesh` renderer
2024-05-01 Change scene
    [scene.blend]
2024-05-01 Fix mesh file generation
    [meshgen.py]
2024-05-01 Fix quaternion math for y-up coordinate system
    [num.h]
2024-05-01 fixed coordinate system math
    [num.h, player.c]
2024-05-02 Remove wrong inline qualifiers
    [num.h]
2024-05-02 Change meshes to right handed coordinate system
    [star_destroyer.ply, x_wing.ply]
2024-05-02 working camera follow, PSoC side
2024-05-02 Working camera follow, host side
    [debug_camera.ply]
2024-05-02 Add asteroids rendering
    [asteroid.ply]
2024-05-07 Setup SDK for Pi Pico
2024-05-07 Add build task using `probe-rs`
2024-05-07 Add and modify `ST7789` driver from Pico examples
2024-05-08 Add DMA to LCD drivers
2024-05-08 Add framebuffer struct
2024-05-09 Add naive fixed point
    [main.c, num.h, rasterizer.c]
2024-05-09 Add fixed-point `vec3` type
    [num.h]
2024-05-09 Add 8.8 fixed-point type
    [num.h]
2024-05-09 Change rasterizer to 100% fixed point
    [main.c, rasterizer.c, rasterizer.h]
2024-05-14 Add SPI component
2024-05-14 flip SPI pins
2024-05-14 Add SPI input using PIO
